towa00/Tracer_Hard/3D/Sensor_Board.stp

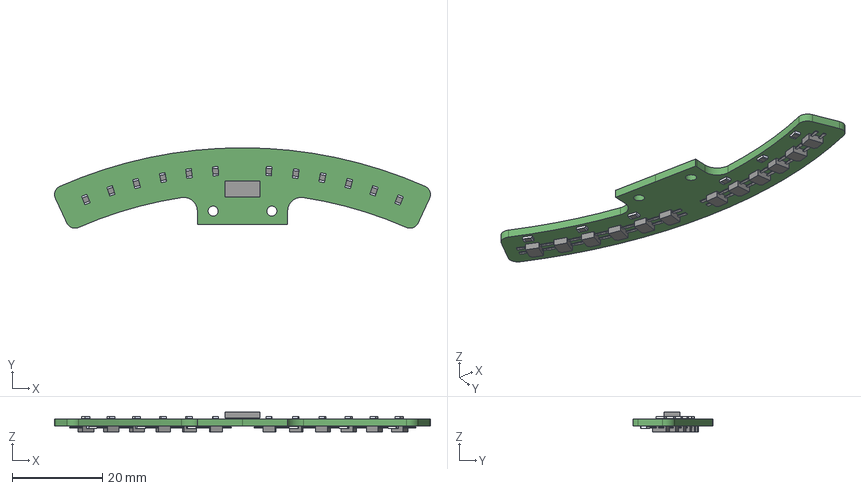
[picture p1: CAD file, 2023-11-23]
3D/Sensor_Board.stp
83.2 x 17.8 x 4.32 mm
