towa00/Tracer_Hard/基板外形(ロボトレース) v17.dxf

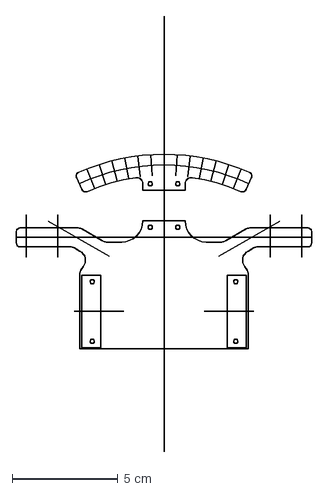
[picture p2: CAD file, 2023-11-23]
基板外形(ロボトレース) v17.dxf
14.0 x 20.6 cm
