towa00/Tracer_Hard/PDF/Back_side.pdf

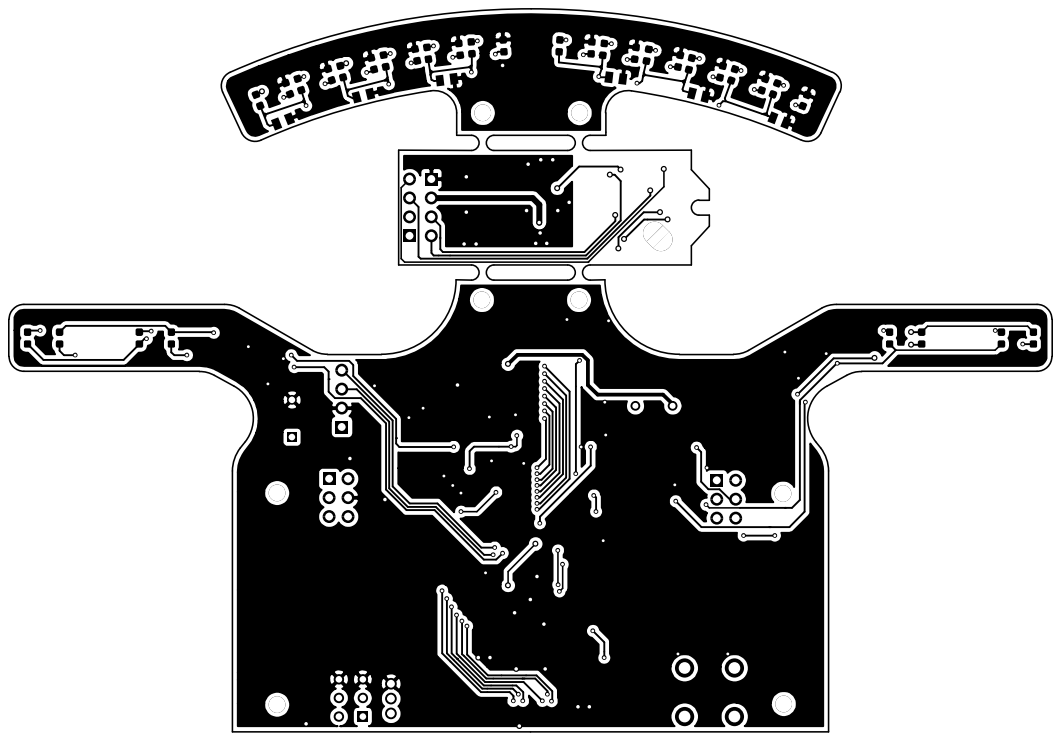
[picture p3: page 1]
