towa00/Tracer_Hard/PDF/Front_side.pdf

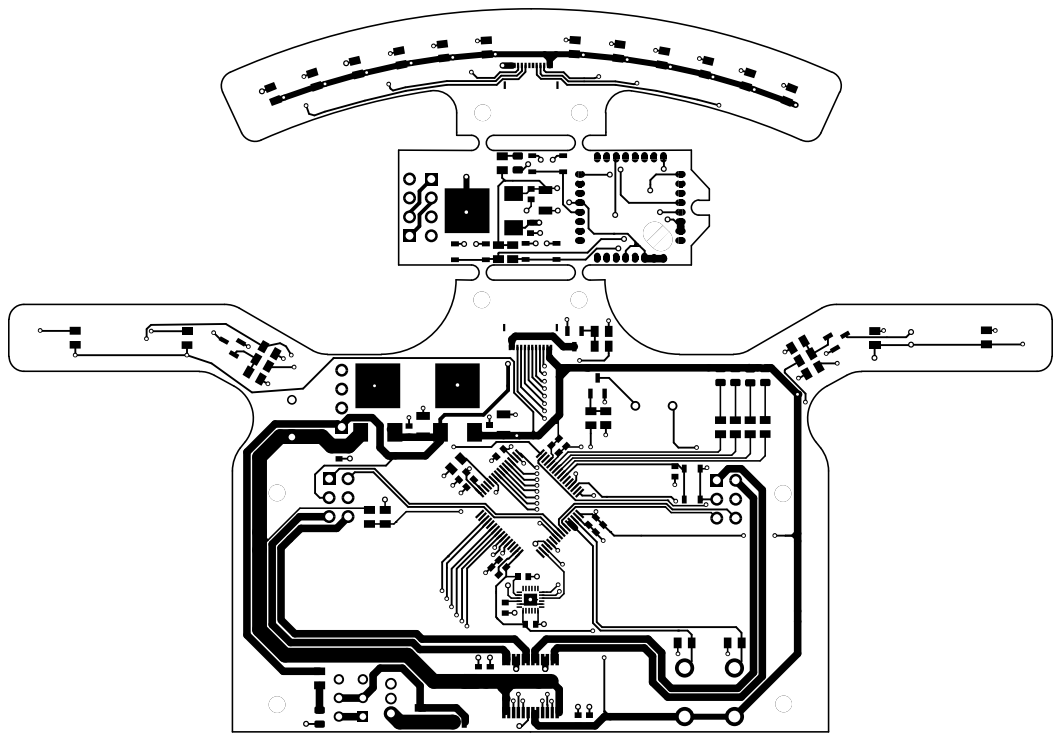
[picture p4: page 1]
