towa00/Tracer_Hard/(list of files, drawings)

Other design files:
Auto_Tracer.dsn
Tracer.dsn
