towa00/Tracer_Hard/Tracer.kicad_pcb

## KiCad design Tracer.kicad_pcb (2023-11-23)

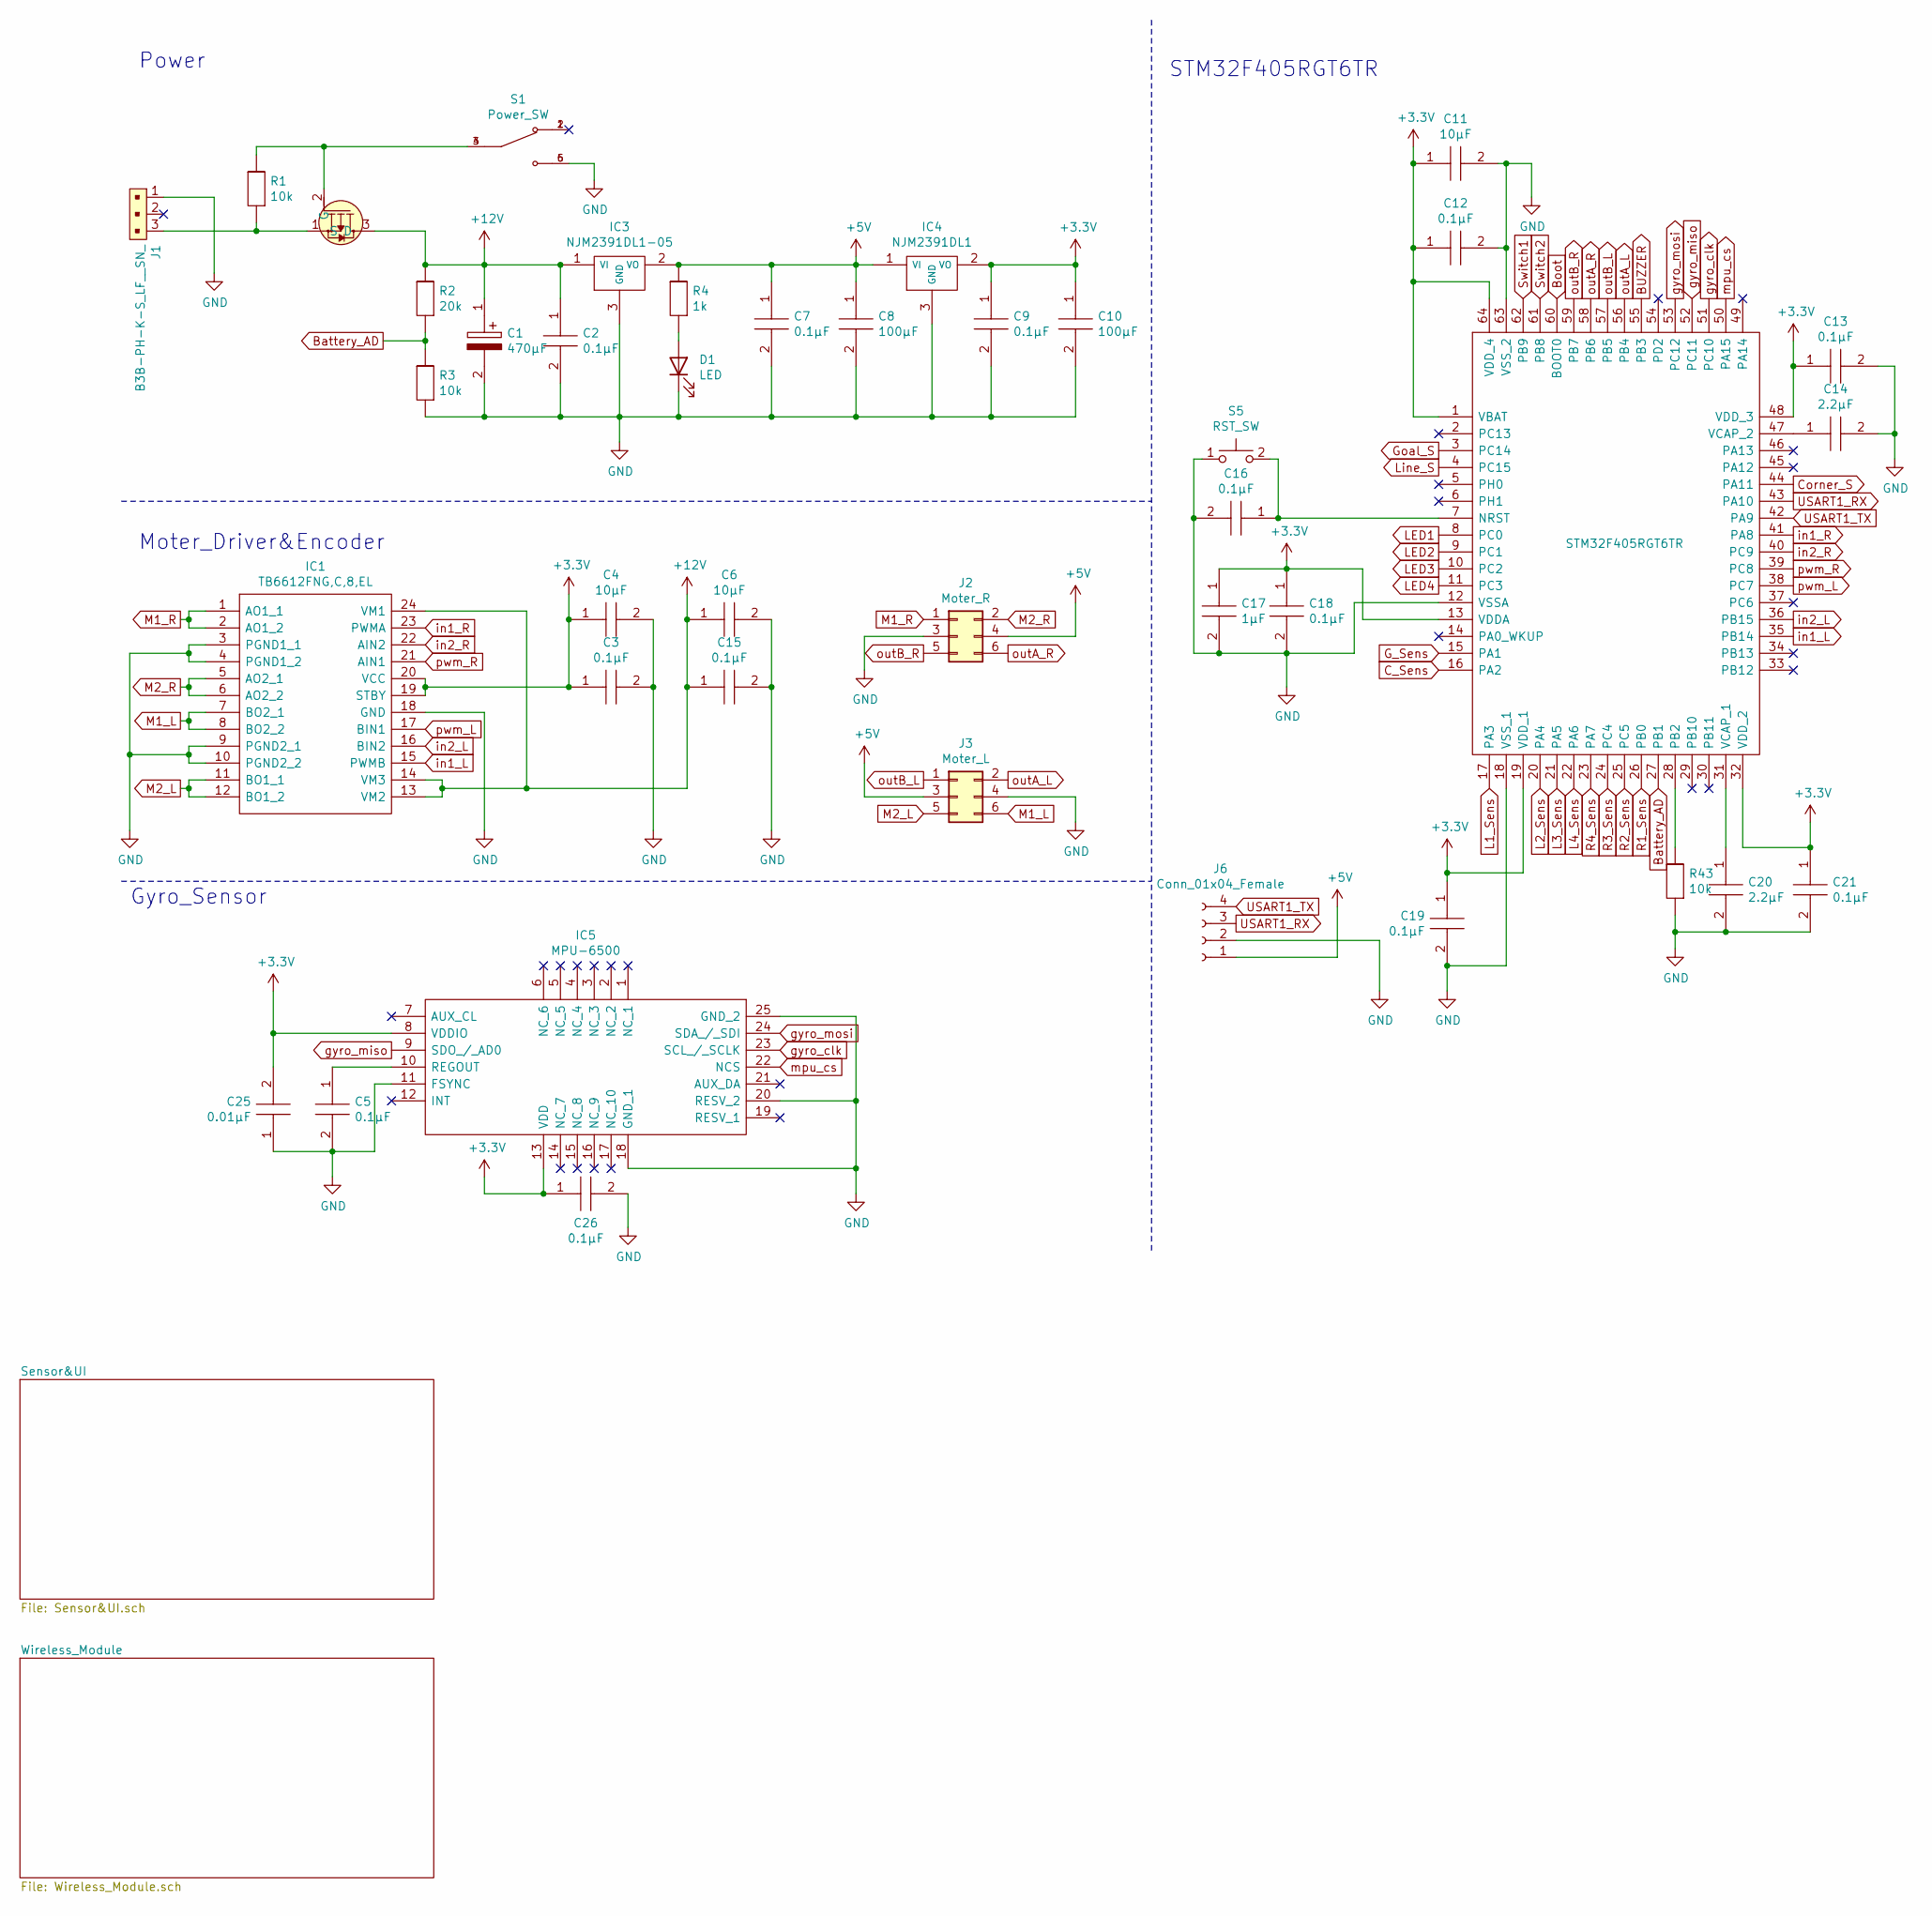
[picture p8: schematic Tracer.sch]

Parts:
C1: 470μF; CAPPRD500W65D1000H1300; Mouser Part Number 667-16SEPC470M
C2, C3, C5, C7, C9, C12, C13, C15, C16, C18, C19, C21, C26: 0.1μF; CAPC1608X90N; Mouser Part Number 81-GRM188R72A104KA35
C4, C6, C11: 10μF; CAPC1608X90N; Mouser Part Number 81-GRM188R6YA106MA3D
C8, C10: 100μF; CAPC3216X180N; Mouser Part Number 81-GRM31CR61A107MA8K
C14, C20: 2.2μF; CAPC1608X90N; Mouser Part Number 81-GRM188R6YA106MA3D
C17: 1μF; CAPC1608X90N; Mouser Part Number 81-GRM188R72A104KA35
C25: 0.01μF; CAPC1608X90N; Mouser Part Number 81-GRM188R72A104KA35
D1: LED; LED_0805_2012Metric
IC1: TB6612FNG,C,8,EL; SOP65P760X160-24N; Mouser Part Number 757-TB6612FNGC8EL
IC2: FDS6576; SOIC127P600X175-8N; Mouser Part Number 512-FDS6576
IC3: NJM2391DL1-05; TO-252-3-L1; Mouser Part Number 513-NJM2391DL133-TE1
IC4: NJM2391DL1; TO-252-3-L1; Mouser Part Number 513-NJM2391DL133-TE1
IC5: MPU-6500; QFN40P300X300X95-25N-D; Mouser Part Number 410-MPU-6500
IC6: STM32F405RGT6TR; QFP50P1200X1200X160-64N; Mouser Part Number 511-STM32F405RGT6TR
J1: B3B-PH-K-S_LF__SN_; PinHeader_1x3_P2mm_Drill1mm; MPN B3B-PH-K-S(LF)(SN); Digi-Key_PN 455-1705-ND
J2: Moter_R; PinHeader_2x03_P2.54mm_Vertical
J3: Moter_L; PinHeader_2x03_P2.54mm_Vertical
J6: Conn_01x04_Female; PinSocket_1x04_P2.54mm_Vertical
R1, R3, R43: 10k; RESC2012X50N
R2: 20k; RESC2012X50N
R4: 1k; RESC2012X50N
S1: Power_SW; SW_MHSS1104; PARTREV A
S5: RST_SW; SMT_4.2X3.2_; Mouser Part Number 688-SKRPACE010

Connections:
+3V3: C3.1, C4.1, C9.1, C10.1, C11.1, C12.1, C13.1, C17.1, C18.1, C19.1, C21.1, C25.2, C26.1, IC1.19 (STBY), IC1.20 (VCC), IC4.2 (VO), IC5.8 (VDDIO), IC5.13 (VDD), IC6.1 (VBAT), IC6.13 (VDDA), IC6.19 (VDD_1), IC6.32 (VDD_2), IC6.48 (VDD_3), IC6.64 (VDD_4); also elsewhere on the board
+5V: C7.1, C8.1, IC3.2 (VO), IC4.1 (VI), J2.4, J3.3, J6.1, R4.1; also elsewhere on the board
+12V: C1.1, C2.1, C6.1, C15.1, IC1.13 (VM2), IC1.14 (VM3), IC1.24 (VM1), IC2.3 (D), IC3.1 (VI), R2.1
BUZZER: IC6.55 (PB3); also elsewhere on the board
Battery_AD: IC6.27 (PB1), R2.2, R3.1
Boot: IC6.60 (BOOT0), IC6.61 (PB8); also elsewhere on the board
C_Sens: IC6.16 (PA2); also elsewhere on the board
Corner_S: IC6.44 (PA11); also elsewhere on the board
GND: C1.2, C2.2, C3.2, C4.2, C5.2, C6.2, C7.2, C8.2, C9.2, C10.2, C11.2, C12.2, C13.2, C14.2, C15.2, C16.2, C17.2, C18.2, C19.2, C20.2, C21.2, C25.1, C26.2, D1.1 (K), IC1.3 (PGND1_1), IC1.4 (PGND1_2), IC1.9 (PGND2_1), IC1.10 (PGND2_2), IC1.18 (GND), IC3.3 (GND), IC4.3 (GND), IC5.11 (FSYNC), IC5.18 (GND_1), IC5.20 (RESV_2), IC5.25 (GND_2), IC6.12 (VSSA), IC6.18 (VSS_1), IC6.63 (VSS_2), J1.1, J2.3, J3.4, J6.2, R3.2, R43.2, S1.5, S1.6, S5.1; also elsewhere on the board
G_Sens: IC6.15 (PA1); also elsewhere on the board
Goal_S: IC6.3 (PC14); also elsewhere on the board
L1_Sens: IC6.17 (PA3); also elsewhere on the board
L2_Sens: IC6.20 (PA4); also elsewhere on the board
L3_Sens: IC6.21 (PA5); also elsewhere on the board
L4_Sens: IC6.22 (PA6); also elsewhere on the board
LED1: IC6.8 (PC0); also elsewhere on the board
LED2: IC6.9 (PC1); also elsewhere on the board
LED3: IC6.10 (PC2); also elsewhere on the board
LED4: IC6.11 (PC3); also elsewhere on the board
Line_S: IC6.4 (PC15); also elsewhere on the board
M1_L: IC1.7 (BO2_1), IC1.8 (BO2_2), J3.6
M1_R: IC1.1 (AO1_1), IC1.2 (AO1_2), J2.1
M2_L: IC1.11 (BO1_1), IC1.12 (BO1_2), J3.5
M2_R: IC1.5 (AO2_1), IC1.6 (AO2_2), J2.2
unnamed: C5.1, IC5.10 (REGOUT)
unnamed: C14.1, IC6.47 (VCAP_2)
unnamed: C16.1, IC6.7 (NRST), S5.2
unnamed: C20.1, IC6.31 (VCAP_1)
unnamed: D1.2 (A), R4.2
unnamed: IC2.1 (S), J1.3, R1.2
unnamed: IC2.2 (G), R1.1, S1.3, S1.4
unnamed: IC6.28 (PB2), R43.1
unnamed: S1.1, S1.2
R1_Sens: IC6.26 (PB0); also elsewhere on the board
R2_Sens: IC6.25 (PC5); also elsewhere on the board
R3_Sens: IC6.24 (PC4); also elsewhere on the board
R4_Sens: IC6.23 (PA7); also elsewhere on the board
Switch1: IC6.62 (PB9); also elsewhere on the board
USART1_RX: IC6.43 (PA10), J6.3
USART1_TX: IC6.42 (PA9), J6.4
gyro_clk: IC5.23 (SCL_/_SCLK), IC6.51 (PC10)
gyro_miso: IC5.9 (SDO_/_AD0), IC6.52 (PC11)
gyro_mosi: IC5.24 (SDA_/_SDI), IC6.53 (PC12)
in1_L: IC1.15 (PWMB), IC6.35 (PB14)
in1_R: IC1.23 (PWMA), IC6.41 (PA8)
in2_L: IC1.16 (BIN2), IC6.36 (PB15)
in2_R: IC1.22 (AIN2), IC6.40 (PC9)
mpu_cs: IC5.22 (NCS), IC6.50 (PA15)
outA_L: IC6.56 (PB4), J3.2
outA_R: IC6.58 (PB6), J2.6
outB_L: IC6.57 (PB5), J3.1
outB_R: IC6.59 (PB7), J2.5
pwm_L: IC1.17 (BIN1), IC6.38 (PC7)
pwm_R: IC1.21 (AIN1), IC6.39 (PC8)

Notes on the sheet:
STM32F405RGT6TR
Gyro_Sensor
Moter_Driver&Encoder
Power

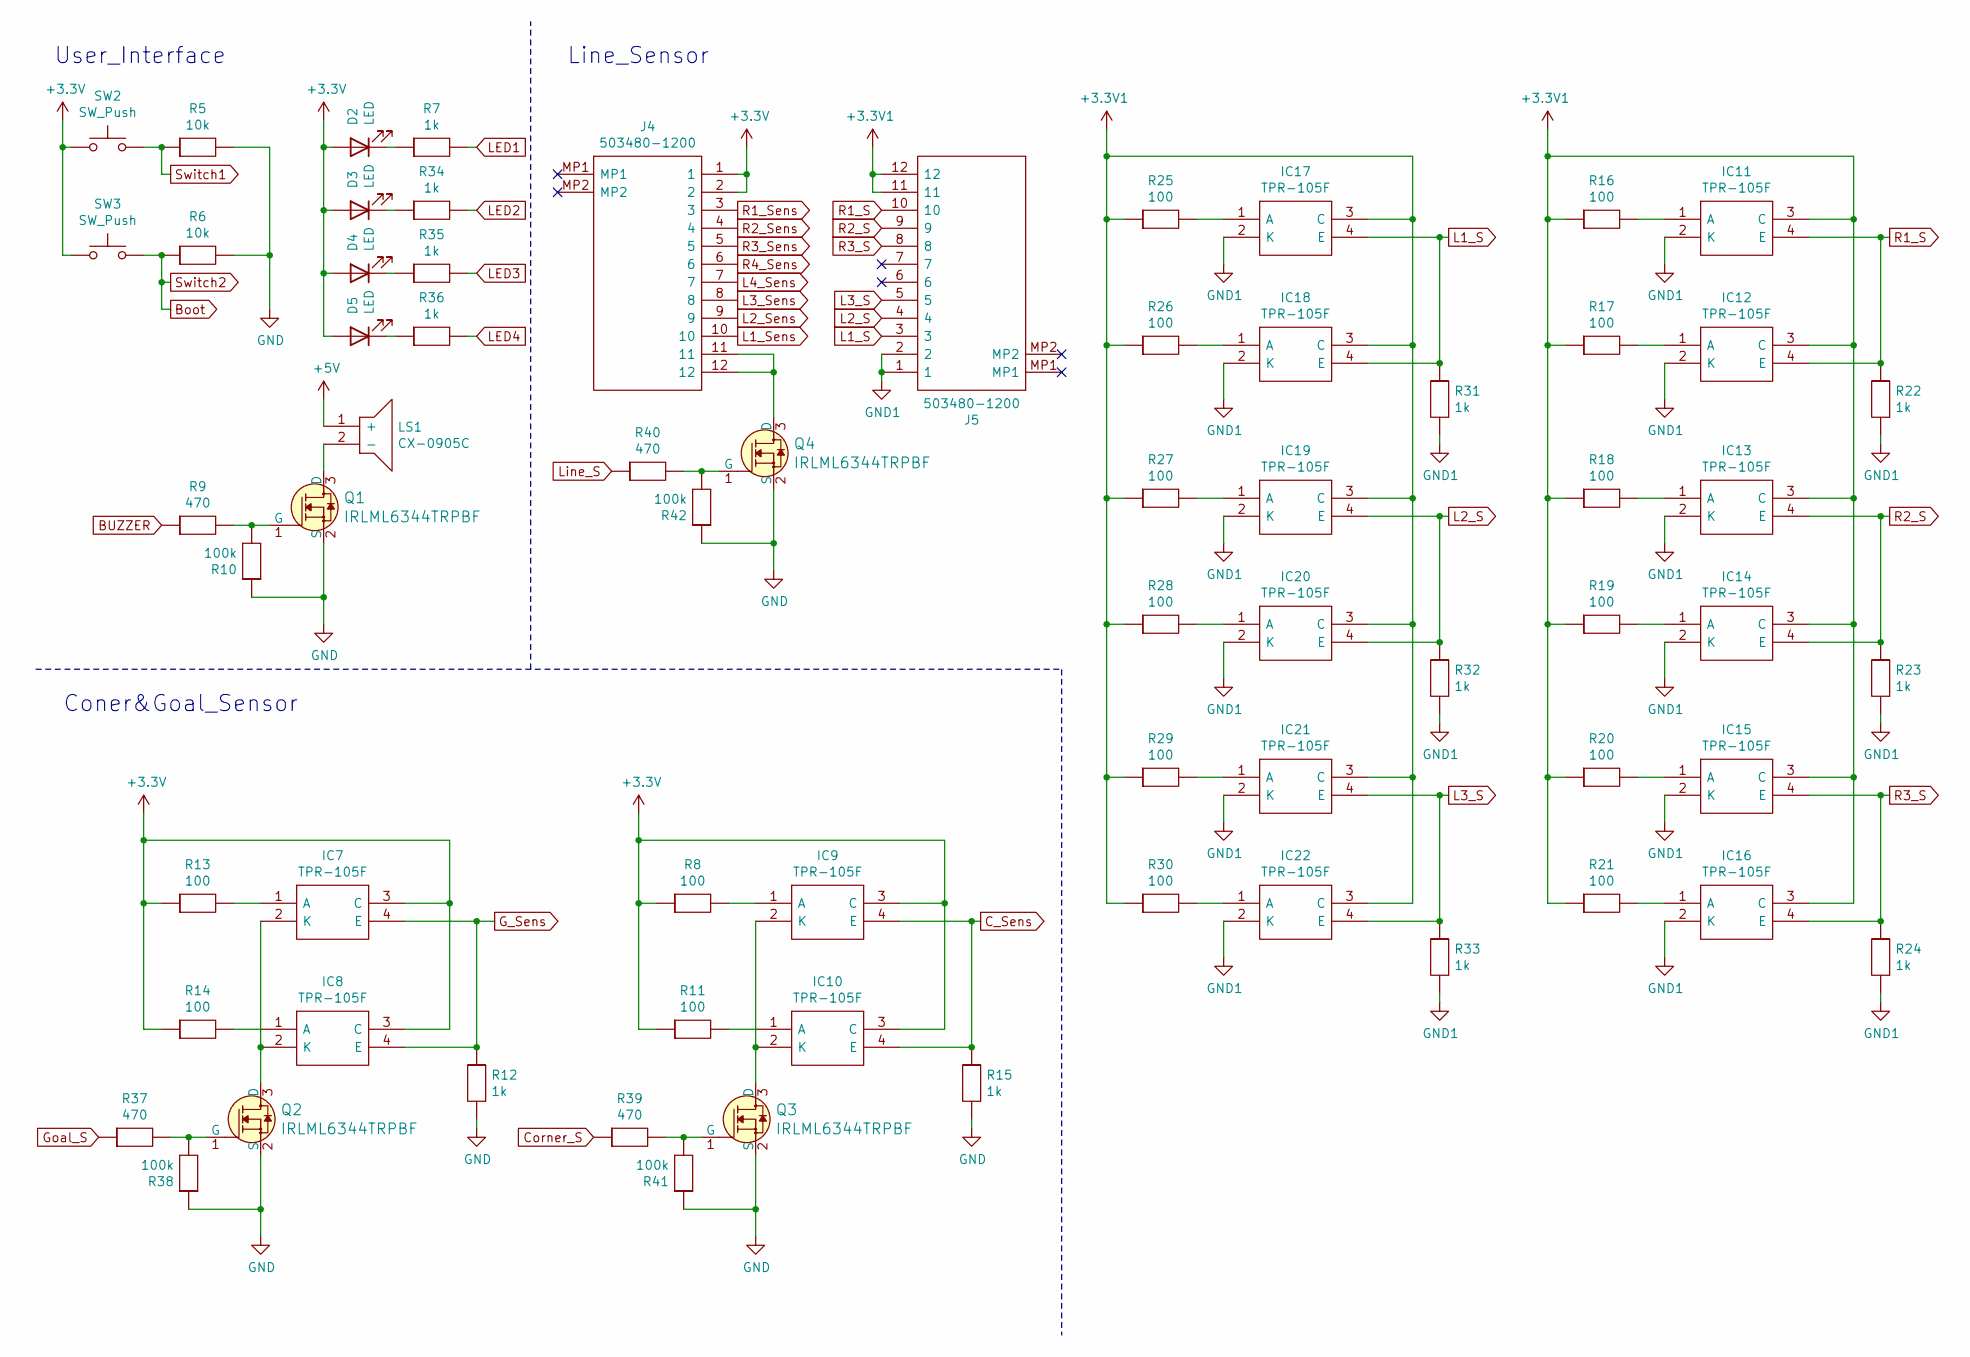
[picture p9: schematic Sensor&UI.sch]

Parts:
D2, D3, D4, D5: LED; LED_0805_2012Metric
IC7, IC8, IC9, IC10, IC11, IC12, IC13, IC14, IC15, IC16, IC17, IC18, IC19, IC20, IC21, IC22: TPR-105F; Mouser Part Number 512-QRE1113
J4, J5: 503480-1200; 5034801200; Mouser Part Number 538-503480-1200
LS1: CX-0905C; CX0905C; Mouser Part Number 490-CX-0905C
Q1, Q2, Q3, Q4: IRLML6344TRPBF; SOT-23-3; MPN IRLML6344TRPBF; Digi-Key_PN IRLML6344TRPBFCT-ND
R5, R6: 10k; RESC2012X50N
R7, R12, R15, R22, R23, R24, R31, R32, R33, R34, R35, R36: 1k; RESC2012X50N
R8, R11, R13, R14, R16, R17, R18, R19, R20, R21, R25, R26, R27, R28, R29, R30: 100; RESC2012X50N
R9, R37, R39, R40: 470; RESC2012X50N
R10, R38, R41, R42: 100k; RESC2012X50N
SW2, SW3: SW_Push; TVBP06-B043CW-B

Connections:
+3.3V1: IC11.3 (C), IC12.3 (C), IC13.3 (C), IC14.3 (C), IC15.3 (C), IC16.3 (C), IC17.3 (C), IC18.3 (C), IC19.3 (C), IC20.3 (C), IC21.3 (C), IC22.3 (C), J5.11, J5.12, R16.1, R17.1, R18.1, R19.1, R20.1, R21.1, R25.1, R26.1, R27.1, R28.1, R29.1, R30.1
+3V3: D2.2 (A), D3.2 (A), D4.2 (A), D5.2 (A), IC7.3 (C), IC8.3 (C), IC9.3 (C), IC10.3 (C), J4.1, J4.2, R8.1, R11.1, R13.1, R14.1, SW2.1, SW3.1; also elsewhere on the board
+5V: LS1.1 (+); also elsewhere on the board
BUZZER: R9.1; also elsewhere on the board
Boot: R6.1, SW3.2; also elsewhere on the board
C_Sens: IC9.4 (E), IC10.4 (E), R15.1; also elsewhere on the board
Corner_S: R39.1; also elsewhere on the board
GND: Q1.2 (S), Q2.2 (S), Q3.2 (S), Q4.2 (S), R5.2, R6.2, R10.1, R12.2, R15.2, R38.1, R41.1, R42.1; also elsewhere on the board
GND1: IC11.2 (K), IC12.2 (K), IC13.2 (K), IC14.2 (K), IC15.2 (K), IC16.2 (K), IC17.2 (K), IC18.2 (K), IC19.2 (K), IC20.2 (K), IC21.2 (K), IC22.2 (K), J5.1, J5.2, R22.2, R23.2, R24.2, R31.2, R32.2, R33.2
G_Sens: IC7.4 (E), IC8.4 (E), R12.1; also elsewhere on the board
Goal_S: R37.1; also elsewhere on the board
L1_S: IC17.4 (E), IC18.4 (E), J5.3, R31.1
L1_Sens: J4.10; also elsewhere on the board
L2_S: IC19.4 (E), IC20.4 (E), J5.4, R32.1
L2_Sens: J4.9; also elsewhere on the board
L3_S: IC21.4 (E), IC22.4 (E), J5.5, R33.1
L3_Sens: J4.8; also elsewhere on the board
L4_Sens: J4.7; also elsewhere on the board
LED1: R7.2; also elsewhere on the board
LED2: R34.2; also elsewhere on the board
LED3: R35.2; also elsewhere on the board
LED4: R36.2; also elsewhere on the board
Line_S: R40.1; also elsewhere on the board
unnamed: D2.1 (K), R7.1
unnamed: D3.1 (K), R34.1
unnamed: D4.1 (K), R35.1
unnamed: D5.1 (K), R36.1
unnamed: IC7.1 (A), R13.2
unnamed: IC7.2 (K), IC8.2 (K), Q2.3 (D)
unnamed: IC8.1 (A), R14.2
unnamed: IC9.1 (A), R8.2
unnamed: IC10.1 (A), R11.2
unnamed: IC9.2 (K), IC10.2 (K), Q3.3 (D)
unnamed: IC11.1 (A), R16.2
unnamed: IC12.1 (A), R17.2
unnamed: IC13.1 (A), R18.2
unnamed: IC14.1 (A), R19.2
unnamed: IC15.1 (A), R20.2
unnamed: IC16.1 (A), R21.2
unnamed: IC17.1 (A), R25.2
unnamed: IC18.1 (A), R26.2
unnamed: IC19.1 (A), R27.2
unnamed: IC20.1 (A), R28.2
unnamed: IC21.1 (A), R29.2
unnamed: IC22.1 (A), R30.2
unnamed: J4.11, J4.12, Q4.3 (D)
unnamed: LS1.2 (-), Q1.3 (D)
unnamed: Q1.1 (G), R9.2, R10.2
unnamed: Q2.1 (G), R37.2, R38.2
unnamed: Q3.1 (G), R39.2, R41.2
unnamed: Q4.1 (G), R40.2, R42.2
R1_S: IC11.4 (E), IC12.4 (E), J5.10, R22.1
R1_Sens: J4.3; also elsewhere on the board
R2_S: IC13.4 (E), IC14.4 (E), J5.9, R23.1
R2_Sens: J4.4; also elsewhere on the board
R3_S: IC15.4 (E), IC16.4 (E), J5.8, R24.1
R3_Sens: J4.5; also elsewhere on the board
R4_Sens: J4.6; also elsewhere on the board
Switch1: R5.1, SW2.2; also elsewhere on the board

Notes on the sheet:
User_Interface
Line_Sensor
Coner&Goal_Sensor

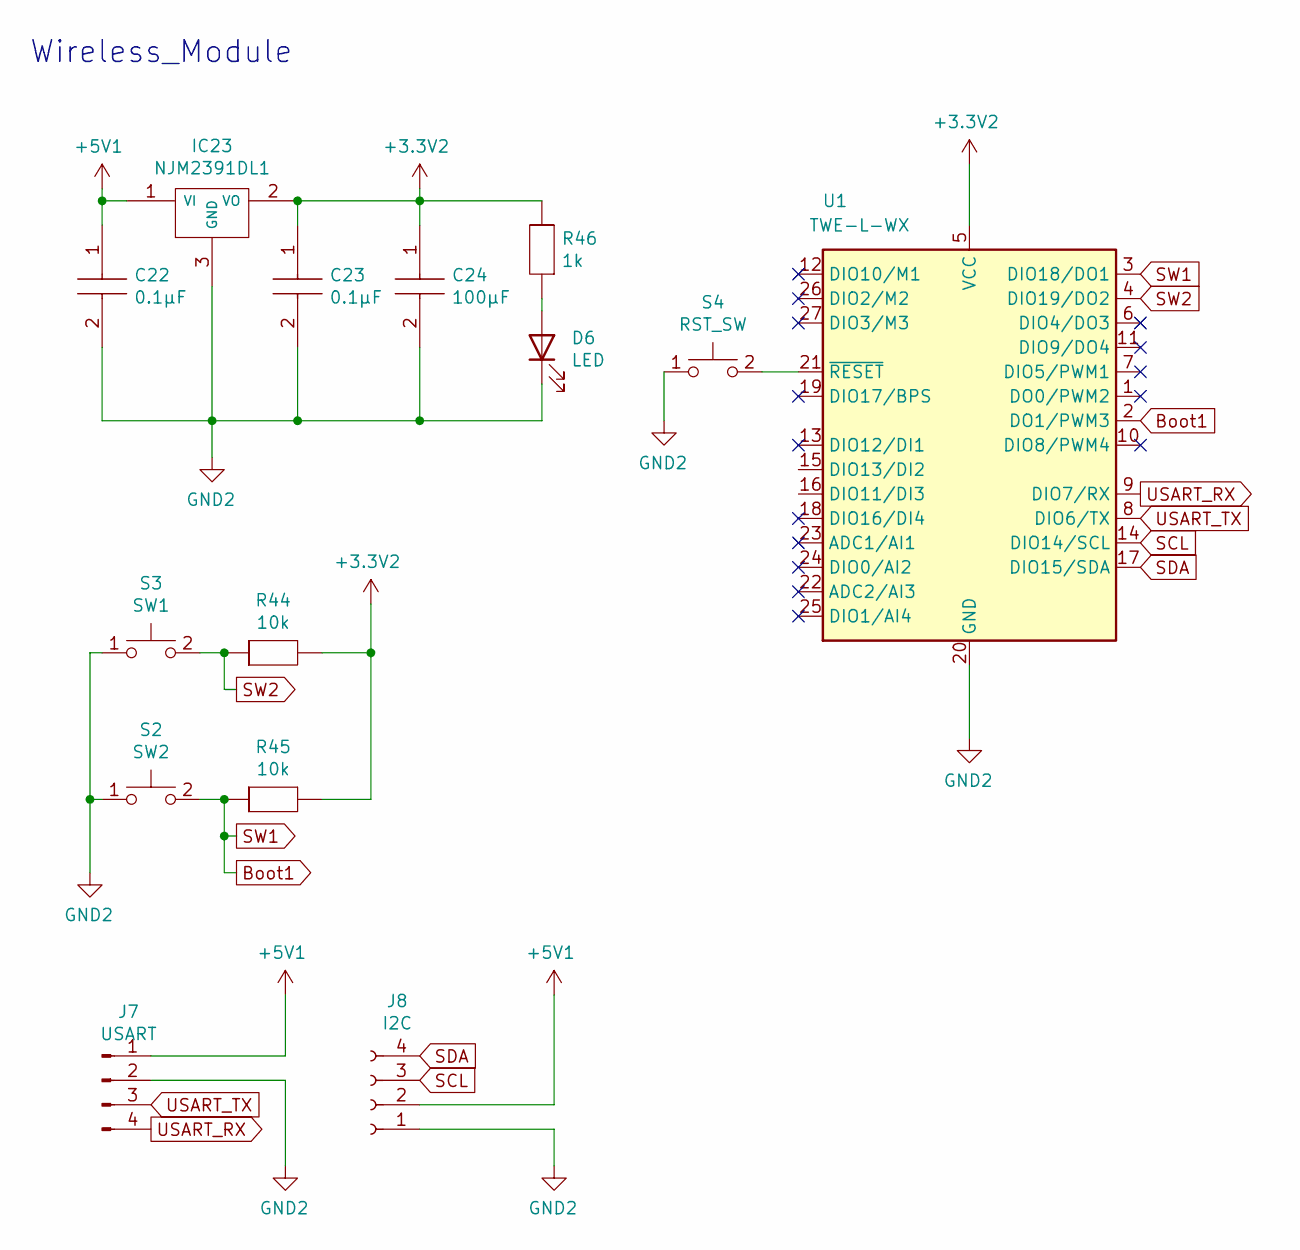
[picture p10: schematic Wireless_Module.sch]

Parts:
C22, C23: 0.1μF; CAPC1608X90N; Mouser Part Number 81-GRM188R72A104KA35
C24: 100μF; CAPC3216X180N; Mouser Part Number 81-GRM31CR61A107MA8K
D6: LED; LED_0805_2012Metric
IC23: NJM2391DL1; TO-252-3-L1; Mouser Part Number 513-NJM2391DL133-TE1
J7: USART; PinHeader_1x04_P2.54mm_Vertical
J8: I2C; PinSocket_1x04_P2.54mm_Vertical
R44, R45: 10k; RESC2012X50N
R46: 1k; RESC2012X50N
S2: SW2; SMT_4.2X3.2_; Mouser Part Number 688-SKRPACE010
S3: SW1; SMT_4.2X3.2_; Mouser Part Number 688-SKRPACE010
S4: RST_SW; SMT_4.2X3.2_; Mouser Part Number 688-SKRPACE010
U1: TWE-L-WX; MonoWireless_TWE-L-WX

Connections:
+3.3V_1: C23.1, C24.1, IC23.2 (VO), R44.2, R45.2, R46.1, U1.5 (VCC)
+5V1: C22.1, IC23.1 (VI), J7.1, J8.2
Boot1: R45.1, S2.2, U1.2 (DO1/PWM3), U1.3 (DIO18/DO1)
GND2: C22.2, C23.2, C24.2, D6.1 (K), IC23.3 (GND), J7.2, J8.1, S2.1, S3.1, S4.1, U1.20 (GND), U1.28 (GND), U1.30 (GND), U1.31 (GND), U1.32 (GND)
unnamed: D6.2 (A), R46.2
unnamed: S4.2, U1.21 (~RESET)
SCL: J8.3, U1.14 (DIO14/SCL)
SDA: J8.4, U1.17 (DIO15/SDA)
SW2: R44.1, S3.2, U1.4 (DIO19/DO2)
USART_RX: J7.4, U1.9 (DIO7/RX)
USART_TX: J7.3, U1.8 (DIO6/TX)

Notes on the sheet:
Wireless_Module

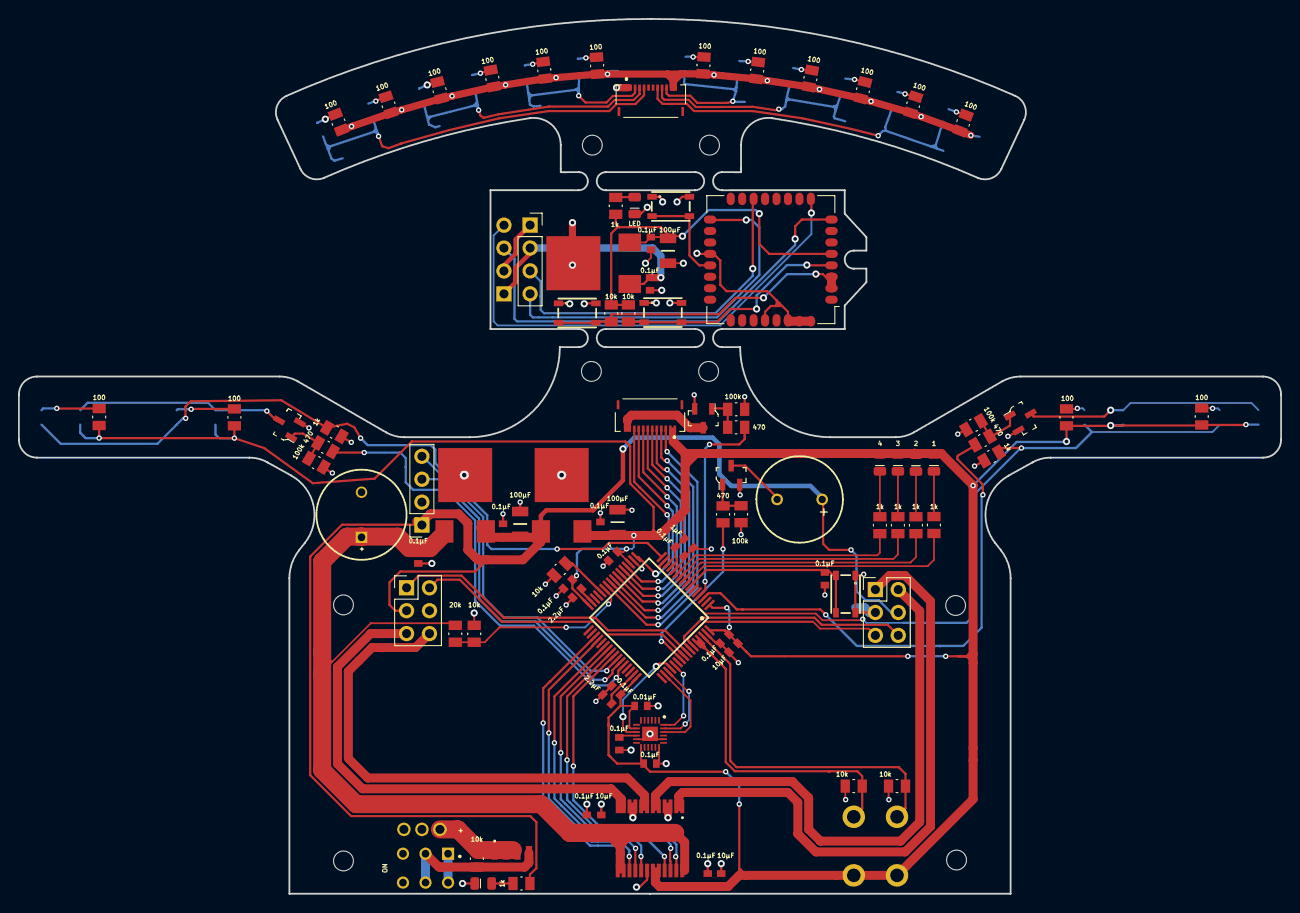
[picture p11: board Tracer.kicad_pcb from above]

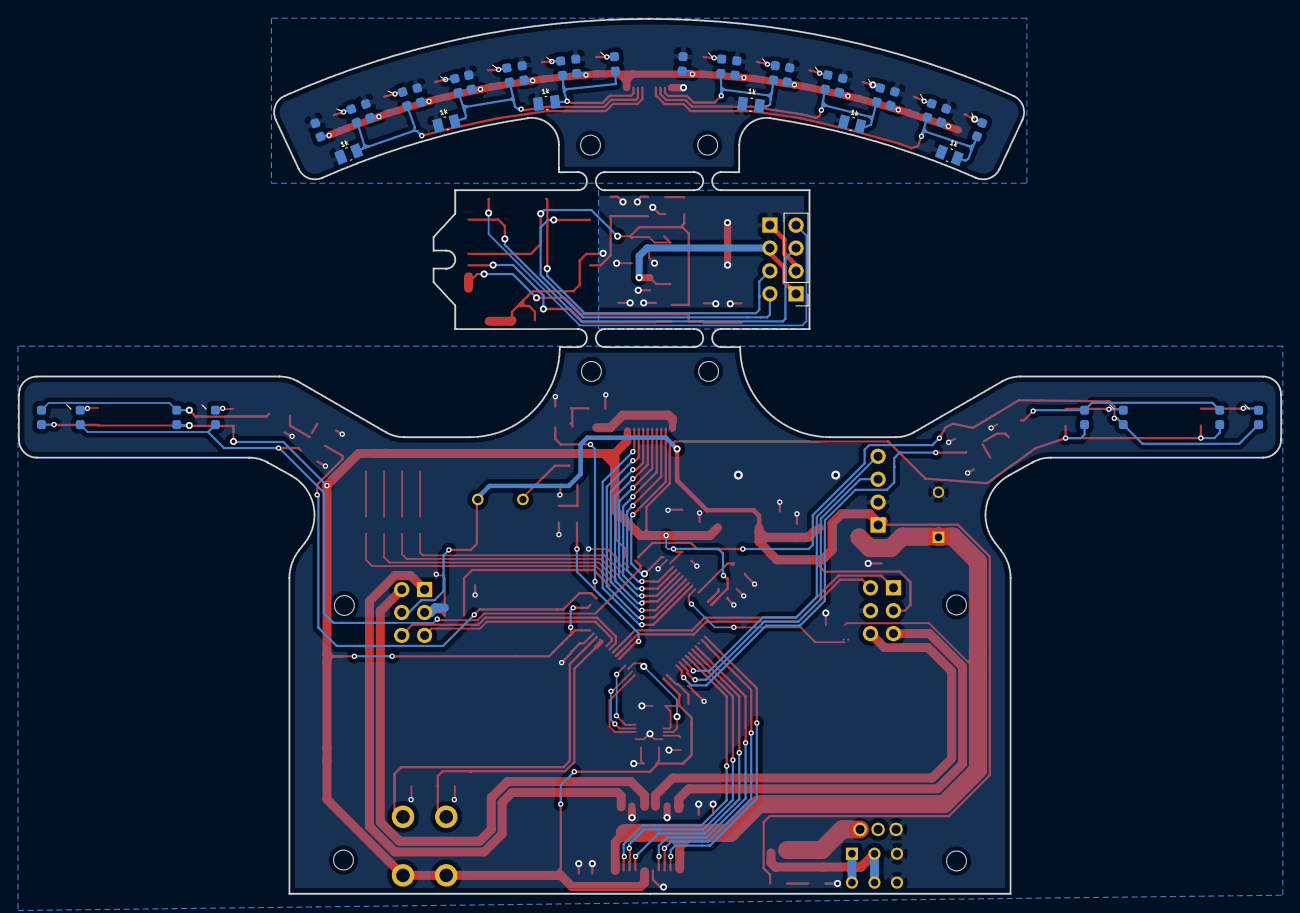
[picture p12: board Tracer.kicad_pcb from below]

Board: 2 copper layers, 140.0 x 97.0 mm, 130 parts (23 on the bottom side), 101 nets.

Other parts of the board:
M2, M2#2, M2#3, M2#4, M2#5, M2#6, M2#7, M2#8: MountingHole_2.2mm_M2
